tuohis/led-controller/loppuraportti/kuvat/kamerakuva_ei_valaistusta.jpg

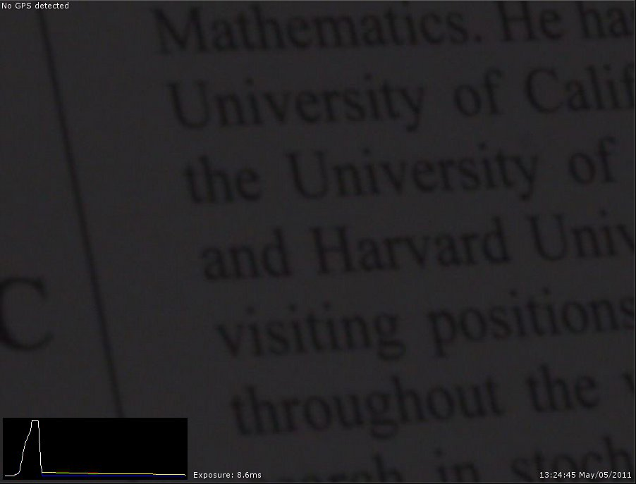
loppuraportti/kuvat/kamerakuva_ei_valaistusta.jpg
