tuohis/led-controller/loppuraportti/kuvat/kamerakuva_saadetty_valaistus.jpg

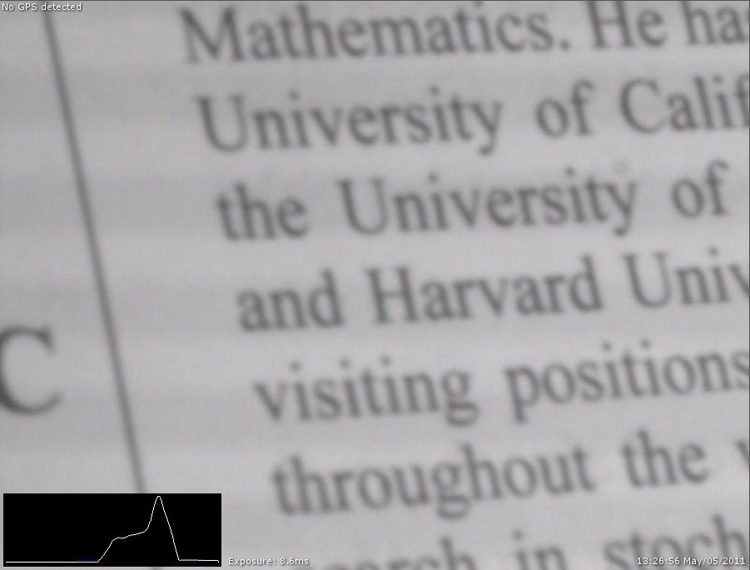
loppuraportti/kuvat/kamerakuva_saadetty_valaistus.jpg
