tuohis/led-controller/loppuraportti/kuvat/kamerakuva_taysi_valaistus.jpg

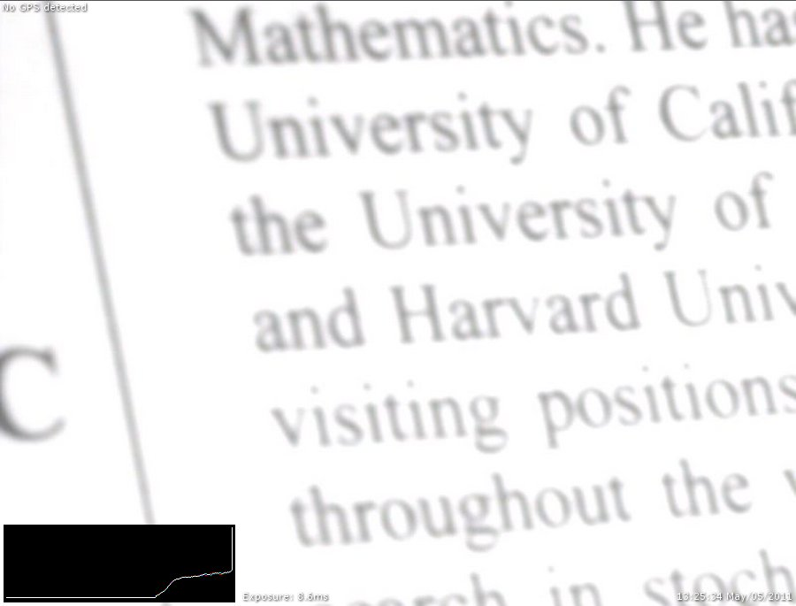
loppuraportti/kuvat/kamerakuva_taysi_valaistus.jpg
