tuohis/led-controller/loppuraportti/kuvat/kamerakuvat_allekkain.jpg

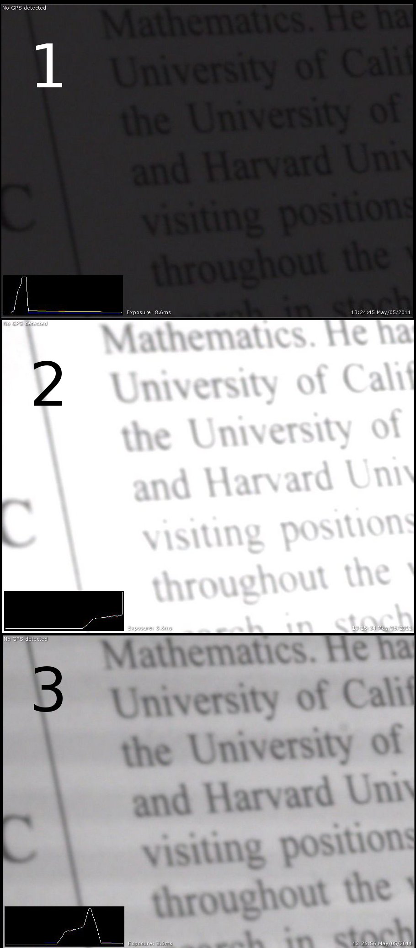
loppuraportti/kuvat/kamerakuvat_allekkain.jpg
