tuohis/led-controller/loppuraportti/kuvat/led.jpg

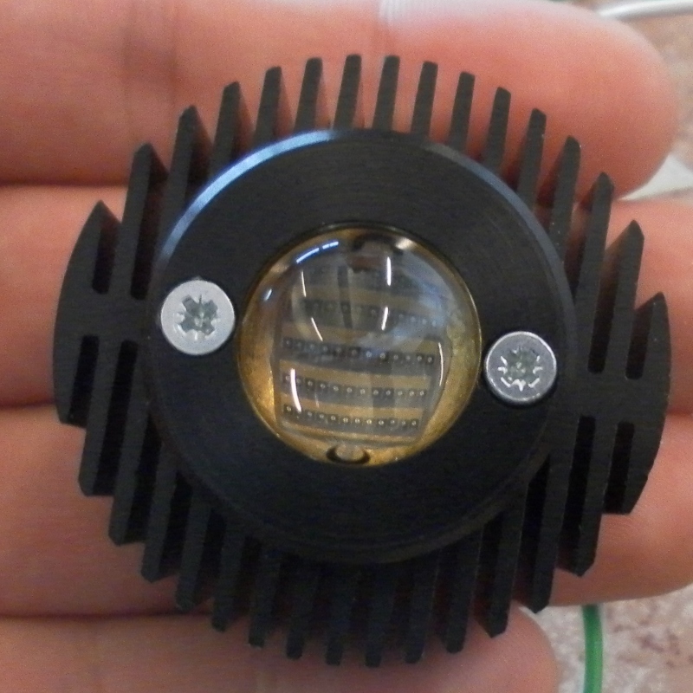
loppuraportti/kuvat/led.jpg
