tuohis/led-controller/loppuraportti/kuvat/tyopoyta.jpg

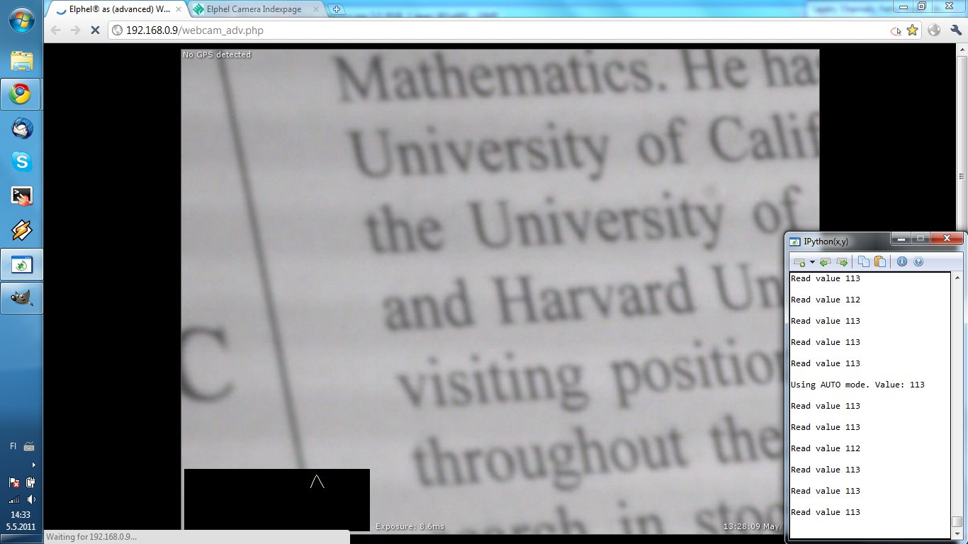
loppuraportti/kuvat/tyopoyta.jpg
