tuohis/led-controller/loppuraportti/kuvat/tyopoyta_led_lahella.jpg

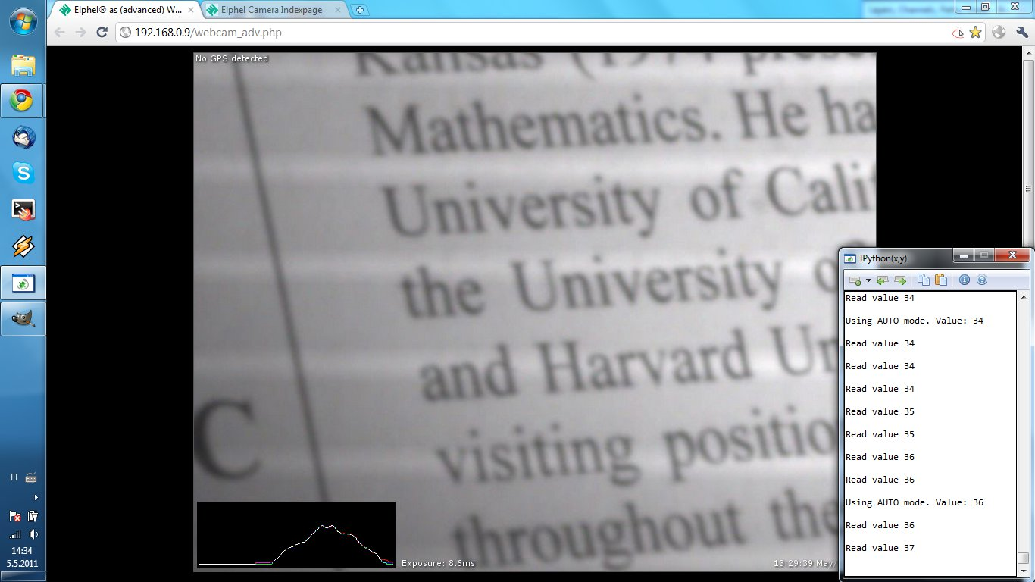
loppuraportti/kuvat/tyopoyta_led_lahella.jpg
