tuohis/led-controller/elektroniikka/asproj-schema.sch

## KiCad design elektroniikka/asproj-schema.sch (2014-10-16)

Schematic: asproj-schema.sch

Parts:
LED780-66-60: LED
Optocoupler: 4N26
R1: R
Rs: R
